Modula-Zaurus/Modula-public/electrical/Shield_L/jlcpcb/production_files/BOM-Shield_L.csv

Comment | Designator | Footprint | LCSC | Quantity
1N4148 | D10,D12,D13,D14,D15,D2,D20,D21,D23,D24,D25,D3,D30,D31,D32,D34,D35,D4,D40,D41,D42,D43,D45,D5,D50,D52,D53,D54,DI0,DI1,DI2,DI3,DI4,DI5,DS0,DS1,DS2,DS3,DS4,DS5 | SOD123_DIO | C81598 | 40
