Modula-Zaurus/Modula-public/electrical/Shield_L/Shield_L_Modula.step

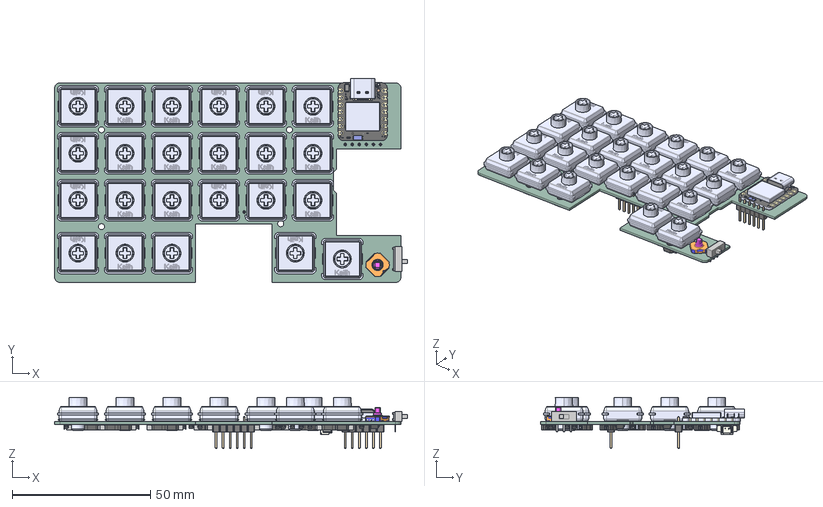
[picture p1: CAD file, 2026-10-31]
electrical/Shield_L/Shield_L_Modula.step
127.7 x 73.8 x 18.5 mm
kailh_choc_socket x 23
Kailh_PG1353 x 23
SKRHAD
Xiao_nRF52840
SlideSwitch_L_type
D_SOD-123 x 40
lock
pins
PinHeader_1x06_P2.54mm_Vertical x 2
Molex_PicoBlade_53261-0271_1x02-1MP_P1.25mm_Horizontal
Shield_L_PCB
