Modula-Zaurus/Modula-public/mechanical/Common/5方向スイッチノブv0.02.3e3.step

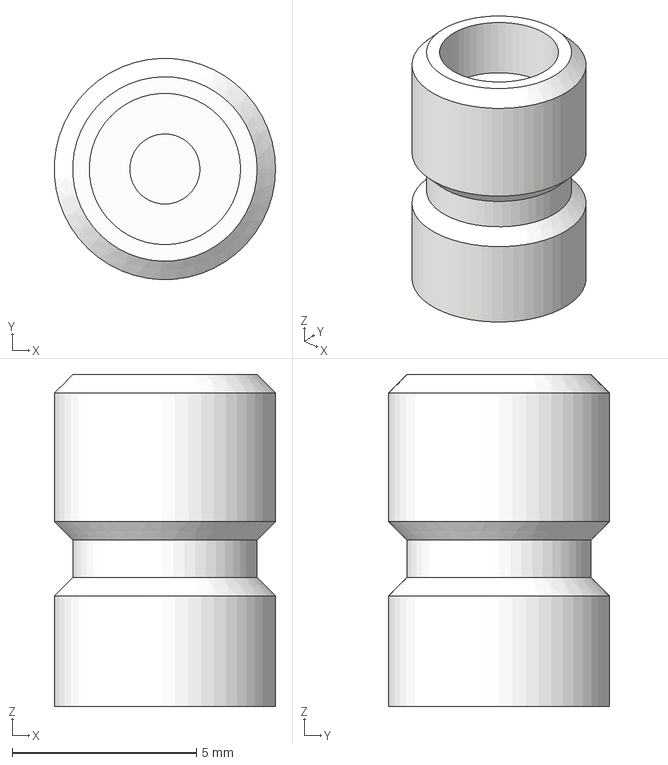
[picture p2: CAD file, 2026-10-31]
mechanical/Common/5方向スイッチノブv0.02.3e3.step
5.99 x 6.00 x 9.00 mm
