Modula-Zaurus/Modula-public/mechanical/Left/ボトムケース_v2_7.step

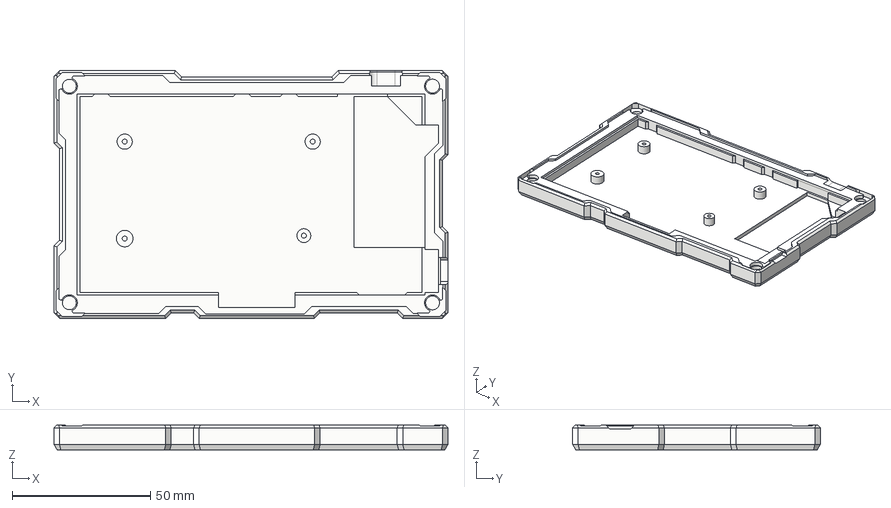
[picture p3: CAD file, 2026-10-31]
mechanical/Left/ボトムケース_v2_7.step
142.5 x 89.6 x 9.00 mm
