Modula-Zaurus/Modula-public/mechanical/Modula_FDM.3mf

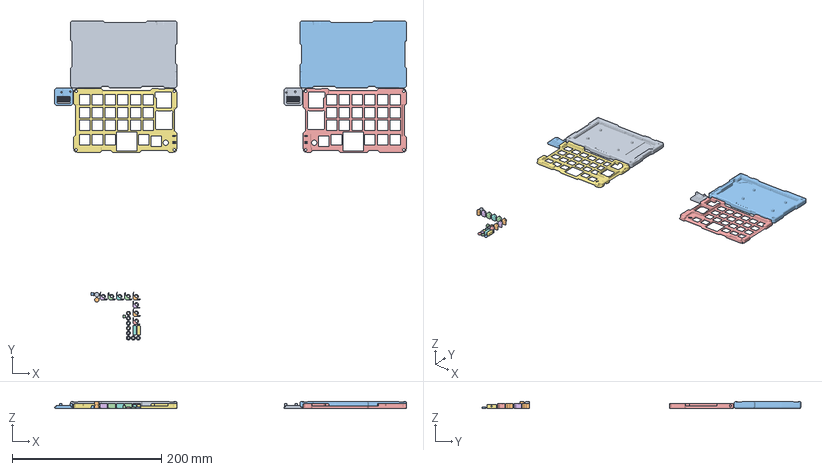
[picture p4: CAD file, 2026-10-31]
mechanical/Modula_FDM.3mf
471.2 x 427.3 x 9.00 mm
ボトムケース_v2_7.step
Modula_ブロックパーツ_LR（左右合計8個印刷）.step x 8
ボトムケース_v2_8.step
トッププレート_v2_4.step
トッププレート_v2_3.step
Modula_マイコンカバー_R.step
Modula_マイコンカバー_L.step
パワースイッチ_スライドパーツ_LR.step x 2
5方向スイッチノブv0.02.3e3.step x 2
Modula_スペーサー（左右合計8個印刷）.step x 8
リセットスイッチ_プッシュパーツ_LR.step x 2
