Modula-Zaurus/Modula-public/mechanical/Common/Modula_マイコンカバー_L.step

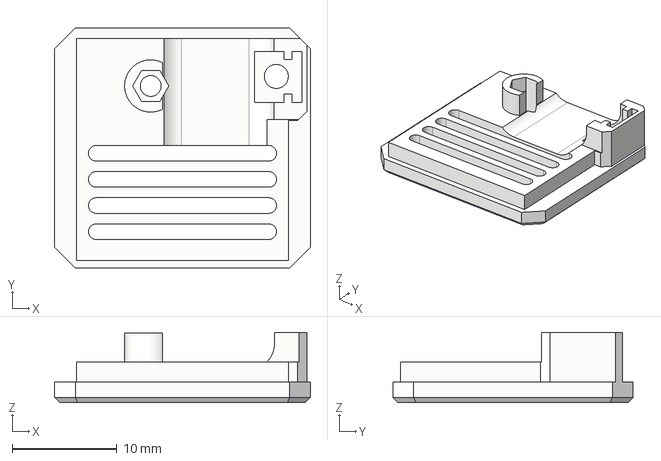
[picture p5: CAD file, 2026-10-31]
mechanical/Common/Modula_マイコンカバー_L.step
24.5 x 23.0 x 6.74 mm
