Modula-Zaurus/Modula-public/mechanical/Left/トッププレート_v2_3.step

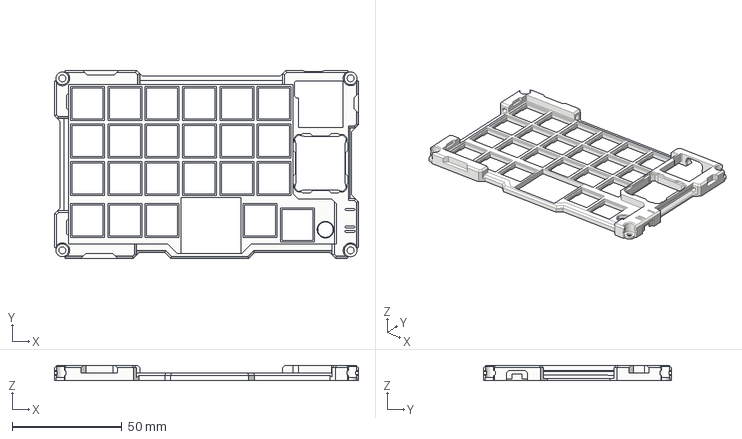
[picture p6: CAD file, 2026-10-31]
mechanical/Left/トッププレート_v2_3.step
138.5 x 85.7 x 6.80 mm
