Modula-Zaurus/Modula-public/mechanical/Common/Modula_ブロックパーツ_LR（左右合計8個印刷）.step

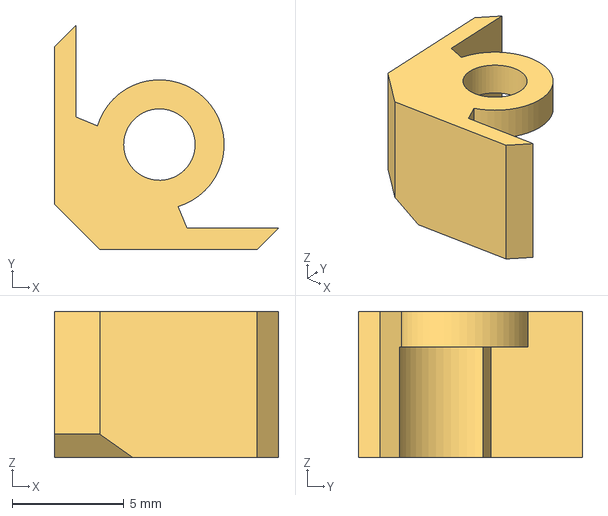
[picture p7: CAD file, 2026-10-31]
mechanical/Common/Modula_ブロックパーツ_LR（左右合計8個印刷）.step
10.0 x 10.0 x 6.55 mm
