Modula-Zaurus/Modula-public/mechanical/Common/Modula_スペーサー（左右合計8個印刷）.step

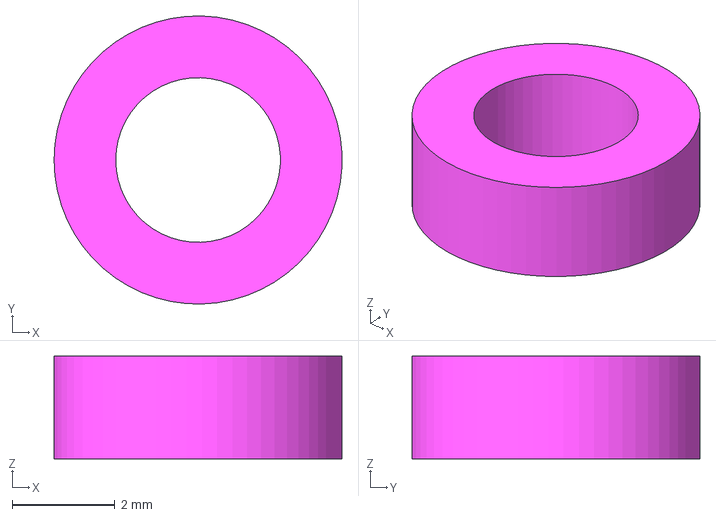
[picture p8: CAD file, 2026-10-31]
mechanical/Common/Modula_スペーサー（左右合計8個印刷）.step
5.60 x 5.60 x 2.00 mm
