Modula-Zaurus/Modula-public/mechanical/Common/リセットスイッチ_プッシュパーツ_LR.step

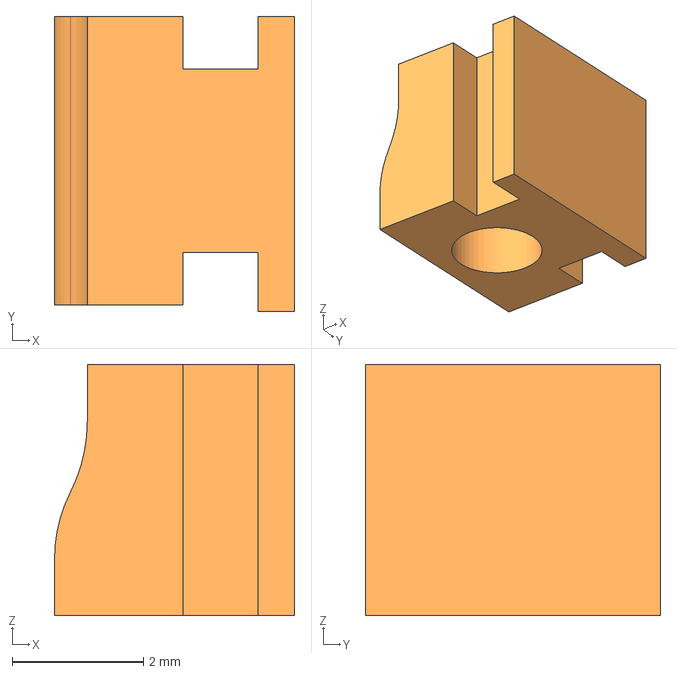
[picture p9: CAD file, 2026-10-31]
mechanical/Common/リセットスイッチ_プッシュパーツ_LR.step
3.66 x 4.50 x 3.84 mm
