Modula-Zaurus/Modula-public/mechanical/Common/パワースイッチ_スライドパーツ_LR.step

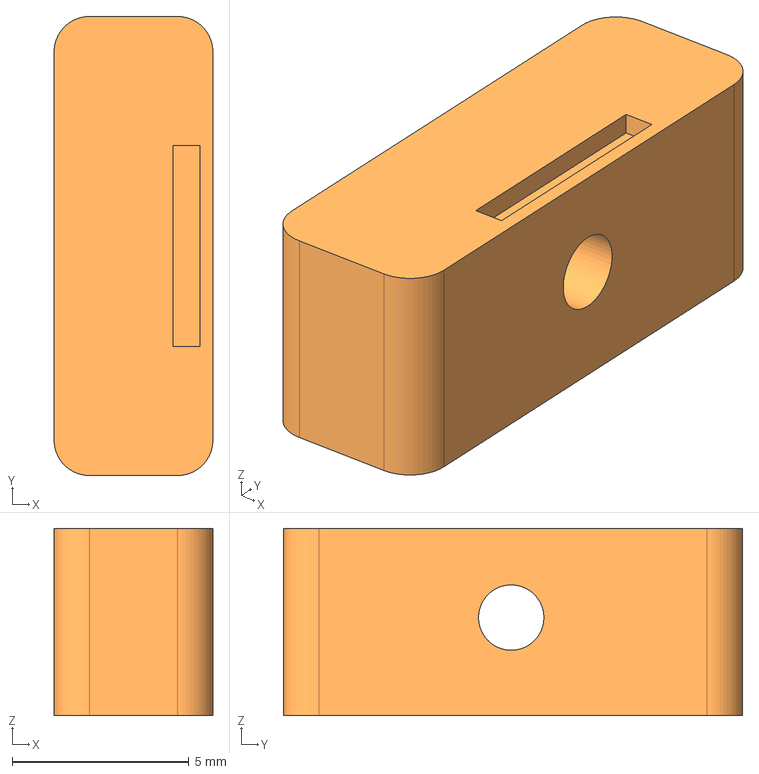
[picture p10: CAD file, 2026-10-31]
mechanical/Common/パワースイッチ_スライドパーツ_LR.step
4.50 x 13.0 x 5.30 mm
