Modula-Zaurus/Modula-public/(list of files, cad)

Other CAD files:
electrical/Shield_R/Shield_R_Modula.step
mechanical/Right/ボトムケース_v2_8.step
mechanical/Right/トッププレート_v2_4.step
mechanical/Common/Modula_マイコンカバー_R.step
