Modula-Zaurus/Modula-public/electrical/Shield_L/Shield_L.kicad_pcb

## KiCad design electrical/Shield_L/Shield_L.kicad_pcb (2026-10-31)

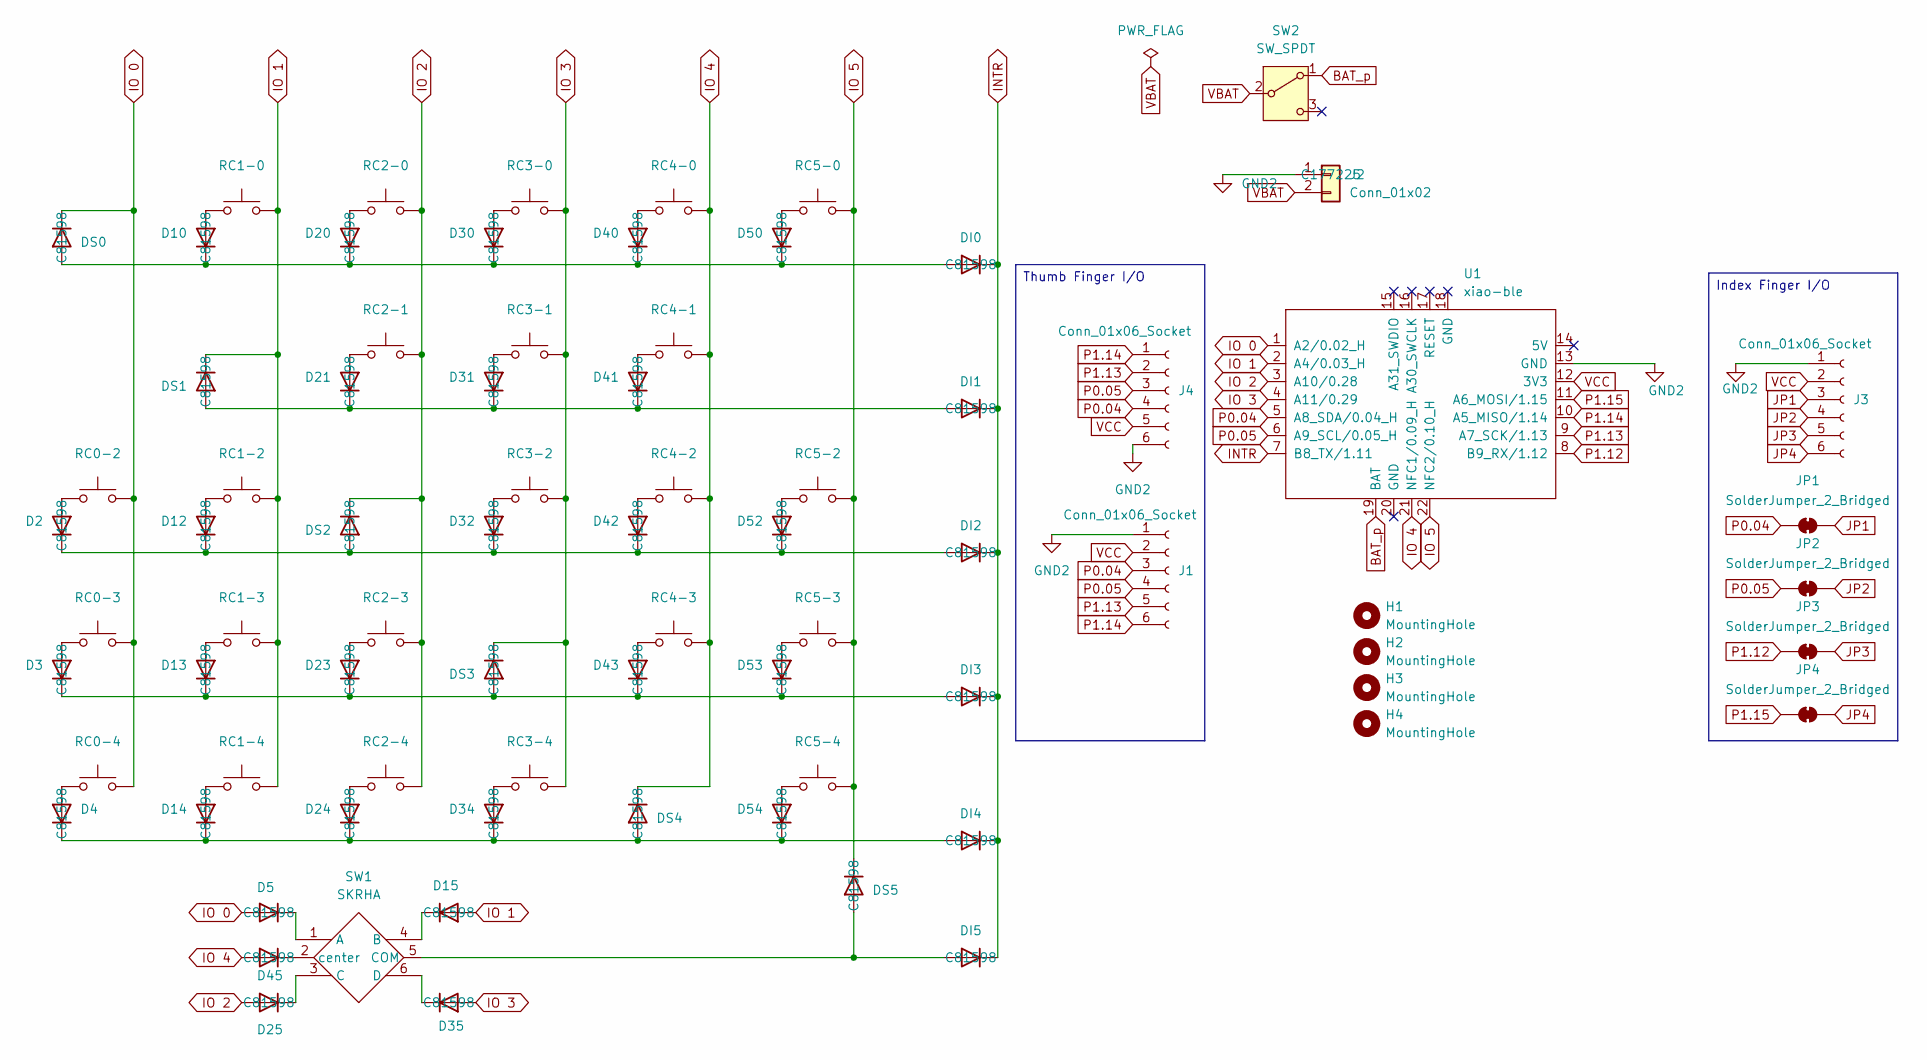
[picture p11: schematic Shield_L.kicad_sch]

Parts:
D2, D3, D4, D5, D10, D12, D13, D14, D15, D20, D21, D23, D24, D25, D30, D31, D32, D34, D35, D40, D41, D42, D43, D45, D50, D52, D53, D54: 1N4148; SOD123_DIO; LCSC C81598
DI0, DI1, DI2, DI3, DI4, DI5: 1N4148; SOD123_DIO; LCSC C81598
DS0, DS1, DS2, DS3, DS4, DS5: 1N4148; SOD123_DIO; LCSC C81598
H1, H2, H3, H4: MountingHole; m2_Screw_Hole
J1, J3: Conn_01x06_Socket; PinHeader_1x06_P2.54mm_Vertical
J2: Conn_01x02; Molex_PicoBlade_53261-0271_1x02-1MP_P1.25mm_Horizontal; LCSC C177225
J4: Conn_01x06_Socket; Hirose_FH12-6S-0.5SH_1x06-1MP_P0.50mm_Horizontal; LCSC C202118
JP1, JP2, JP3, JP4: SolderJumper_2_Bridged; SolderJumper-2_P1.3mm_Open_RoundedPad1.0x1.5mm
RC0-2, RC0-3, RC0-4, RC1-0, RC1-2, RC1-3, RC1-4, RC2-0, RC2-1, RC2-3, RC2-4, RC3-0, RC3-1, RC3-2, RC3-4, RC4-0, RC4-1, RC4-2, RC4-3, RC5-0, RC5-2, RC5-3, RC5-4: SW_Push; Choc_v2_Hotswap_1u_narrow
SW1: SKRHA; SKRHA-boss
SW2: SW_SPDT; SW_Slide-03_Wuerth-WS-SLTV_10x2.5x6.4_P2.54mm
U1: xiao-ble; xiao-ble-smd-cutout

Connections:
BAT_p: SW2.1 (A), U1.19 (BAT)
GND2: J1.1, J2.1, J3.1, J4.6, U1.13 (GND)
INTR: DI0.1 (K), DI1.1 (K), DI2.1 (K), DI3.1 (K), DI4.1 (K), DI5.1 (K), U1.7 (B8_TX/1.11)
IO 0: D5.2 (A), DS0.1 (K), RC0-2.1, RC0-3.1, RC0-4.1, U1.1 (A2/0.02_H)
IO 1: D15.2 (A), DS1.1 (K), RC1-0.1, RC1-2.1, RC1-3.1, RC1-4.1, U1.2 (A4/0.03_H)
IO 2: D25.2 (A), DS2.1 (K), RC2-0.1, RC2-1.1, RC2-3.1, RC2-4.1, U1.3 (A10/0.28)
IO 3: D35.2 (A), DS3.1 (K), RC3-0.1, RC3-1.1, RC3-2.1, RC3-4.1, U1.4 (A11/0.29)
IO 4: D45.2 (A), DS4.1 (K), RC4-0.1, RC4-1.1, RC4-2.1, RC4-3.1, U1.21 (NFC1/0.09_H)
IO 5: DS5.1 (K), RC5-0.1, RC5-2.1, RC5-3.1, RC5-4.1, U1.22 (NFC2/0.10_H)
JP1: J3.3, JP1.2 (B)
JP2: J3.4, JP2.2 (B)
JP3: J3.5, JP3.2 (B)
JP4: J3.6, JP4.2 (B)
unnamed: D2.2 (A), RC0-2.2
unnamed: D3.2 (A), RC0-3.2
unnamed: D4.2 (A), RC0-4.2
unnamed: D5.1 (K), SW1.1 (A)
unnamed: D10.2 (A), RC1-0.2
unnamed: D10.1 (K), D20.1 (K), D30.1 (K), D40.1 (K), D50.1 (K), DI0.2 (A), DS0.2 (A)
unnamed: D12.2 (A), RC1-2.2
unnamed: D2.1 (K), D12.1 (K), D32.1 (K), D42.1 (K), D52.1 (K), DI2.2 (A), DS2.2 (A)
unnamed: D13.2 (A), RC1-3.2
unnamed: D3.1 (K), D13.1 (K), D23.1 (K), D43.1 (K), D53.1 (K), DI3.2 (A), DS3.2 (A)
unnamed: D14.2 (A), RC1-4.2
unnamed: D4.1 (K), D14.1 (K), D24.1 (K), D34.1 (K), D54.1 (K), DI4.2 (A), DS4.2 (A)
unnamed: D15.1 (K), SW1.4 (B)
unnamed: D20.2 (A), RC2-0.2
unnamed: D21.2 (A), RC2-1.2
unnamed: D21.1 (K), D31.1 (K), D41.1 (K), DI1.2 (A), DS1.2 (A)
unnamed: D23.2 (A), RC2-3.2
unnamed: D24.2 (A), RC2-4.2
unnamed: D25.1 (K), SW1.3 (C)
unnamed: D30.2 (A), RC3-0.2
unnamed: D31.2 (A), RC3-1.2
unnamed: D32.2 (A), RC3-2.2
unnamed: D34.2 (A), RC3-4.2
unnamed: D35.1 (K), SW1.6 (D)
unnamed: D40.2 (A), RC4-0.2
unnamed: D41.2 (A), RC4-1.2
unnamed: D42.2 (A), RC4-2.2
unnamed: D43.2 (A), RC4-3.2
unnamed: D45.1 (K), SW1.2 (center)
unnamed: D50.2 (A), RC5-0.2
unnamed: D52.2 (A), RC5-2.2
unnamed: D53.2 (A), RC5-3.2
unnamed: D54.2 (A), RC5-4.2
unnamed: DI5.2 (A), DS5.2 (A), SW1.5 (COM)
P0.04: J1.3, J4.4, JP1.1 (A), U1.5 (A8_SDA/0.04_H)
P0.05: J1.4, J4.3, JP2.1 (A), U1.6 (A9_SCL/0.05_H)
P1.12: JP3.1 (A), U1.8 (B9_RX/1.12)
P1.13: J1.5, J4.2, U1.9 (A7_SCK/1.13)
P1.14: J1.6, J4.1, U1.10 (A5_MISO/1.14)
P1.15: JP4.1 (A), U1.11 (A6_MOSI/1.15)
VBAT: J2.2, SW2.2 (B)
VCC: J1.2, J3.2, J4.5, U1.12 (3V3)

Notes on the sheet:
Index Finger I/O
Thumb Finger I/O

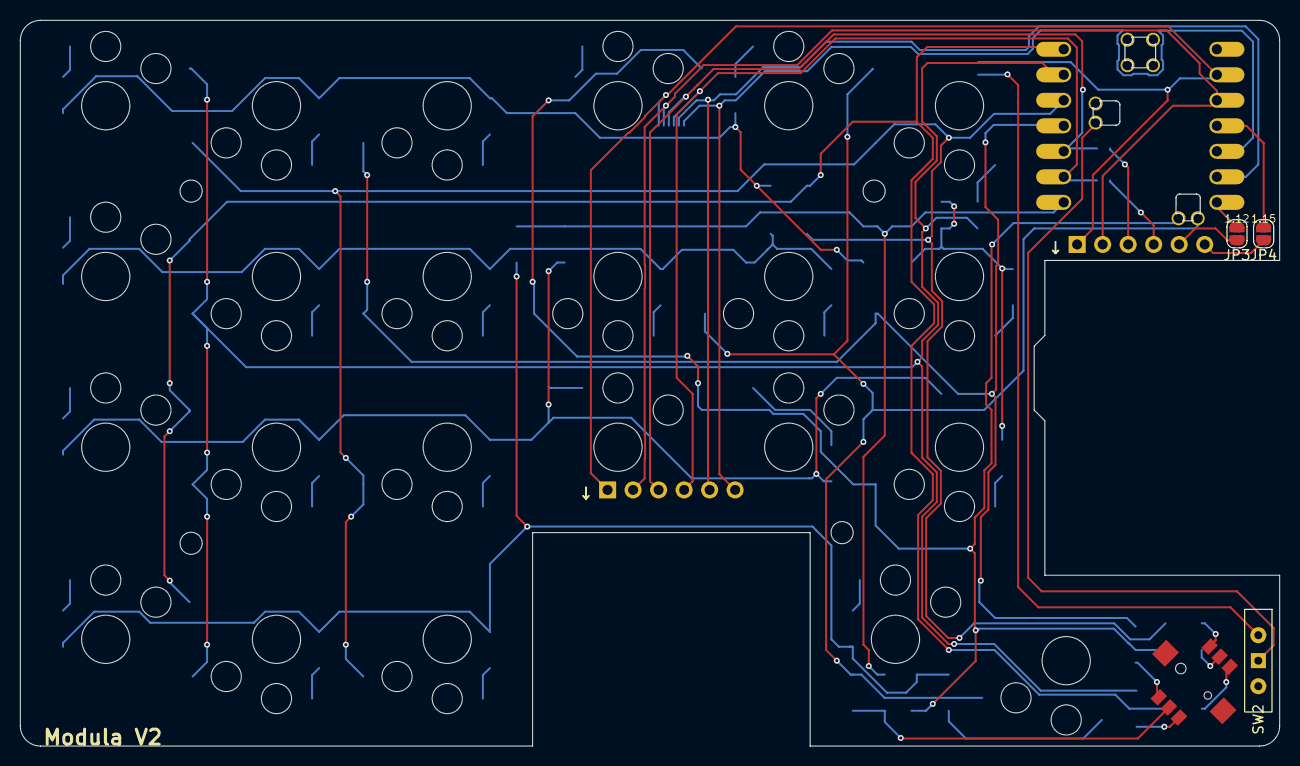
[picture p12: board Shield_L.kicad_pcb from above]

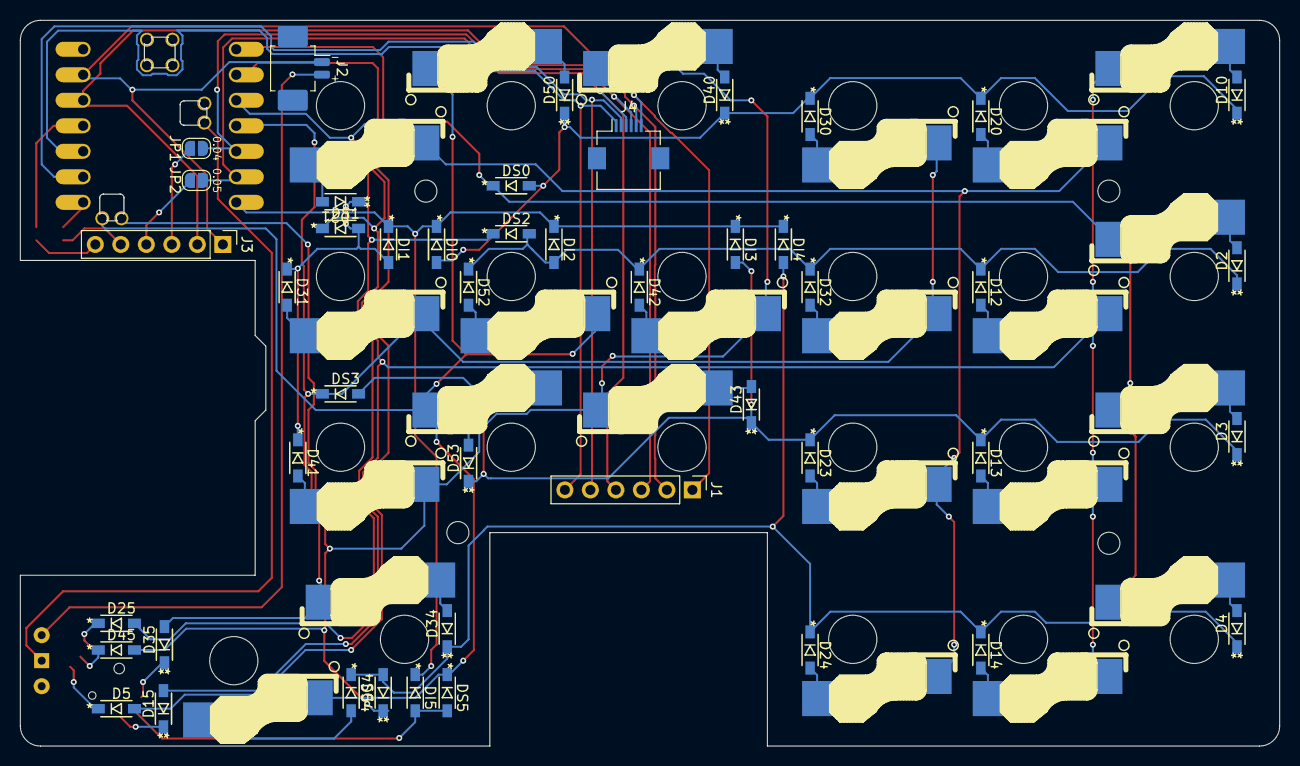
[picture p13: board Shield_L.kicad_pcb from below]

Board: 2 copper layers, 125.4 x 72.2 mm, 78 parts (46 on the bottom side), 55 nets.
